GadgetReboot/PSM60_Fader_Controller/README.md

# PSM60_Fader_Controller
Motorized fader pot controller
