GadgetReboot/PSM60_Fader_Controller/Sketch/readme.md

FadePotTestATTiny804.ino is the sketch for the ATTiny804 controlling the fader pot motor<br>
fader_pot_controller_demo.ino is an I2C controller demo sketch for Uno to accept user input from the serial monitor and control the fader pot over I2C
