GadgetReboot/PSM60_Fader_Controller/GR_Slide_Pot_Controller_Sch.pdf

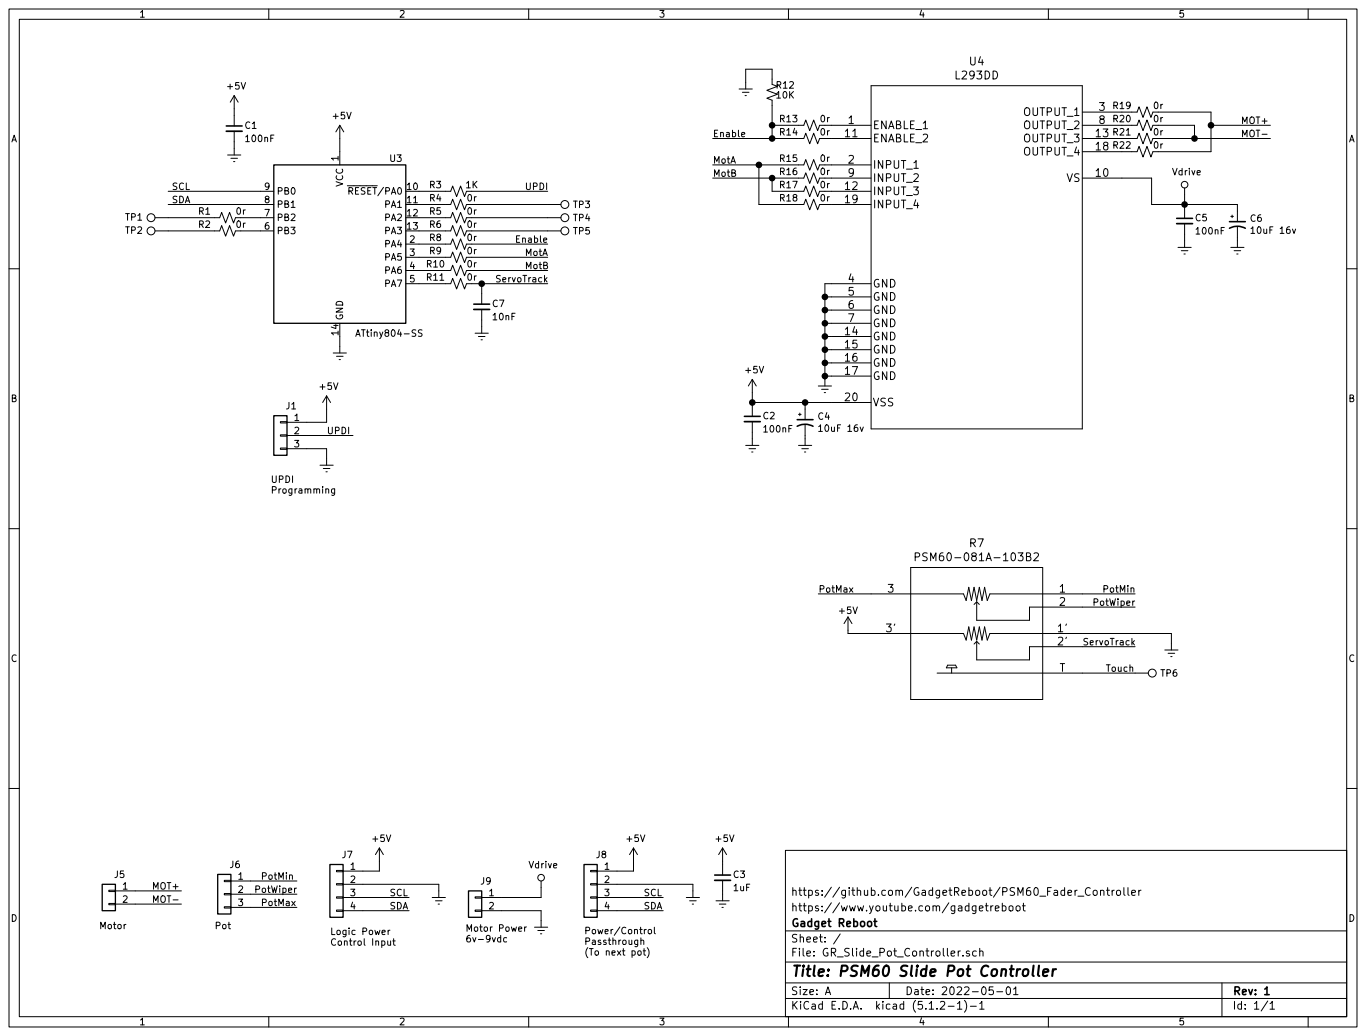
[picture p1: page 1]

https://github.com/GadgetReboot/PSM60_Fader_Controller C3

(To next pot) SDA

https://www.youtube.com/gadgetreboot
File: GR_Slide_Pot_Controller.sch Sheet: / Gadget Reboot

Id: 1/1 Title: PSM60 Slide Pot Controller
