GadgetReboot/PSM60_Fader_Controller/KiCad/GR_Slide_Pot_Controller.kicad_pcb

## KiCad design KiCad/GR_Slide_Pot_Controller.kicad_pcb (2023-11-27)

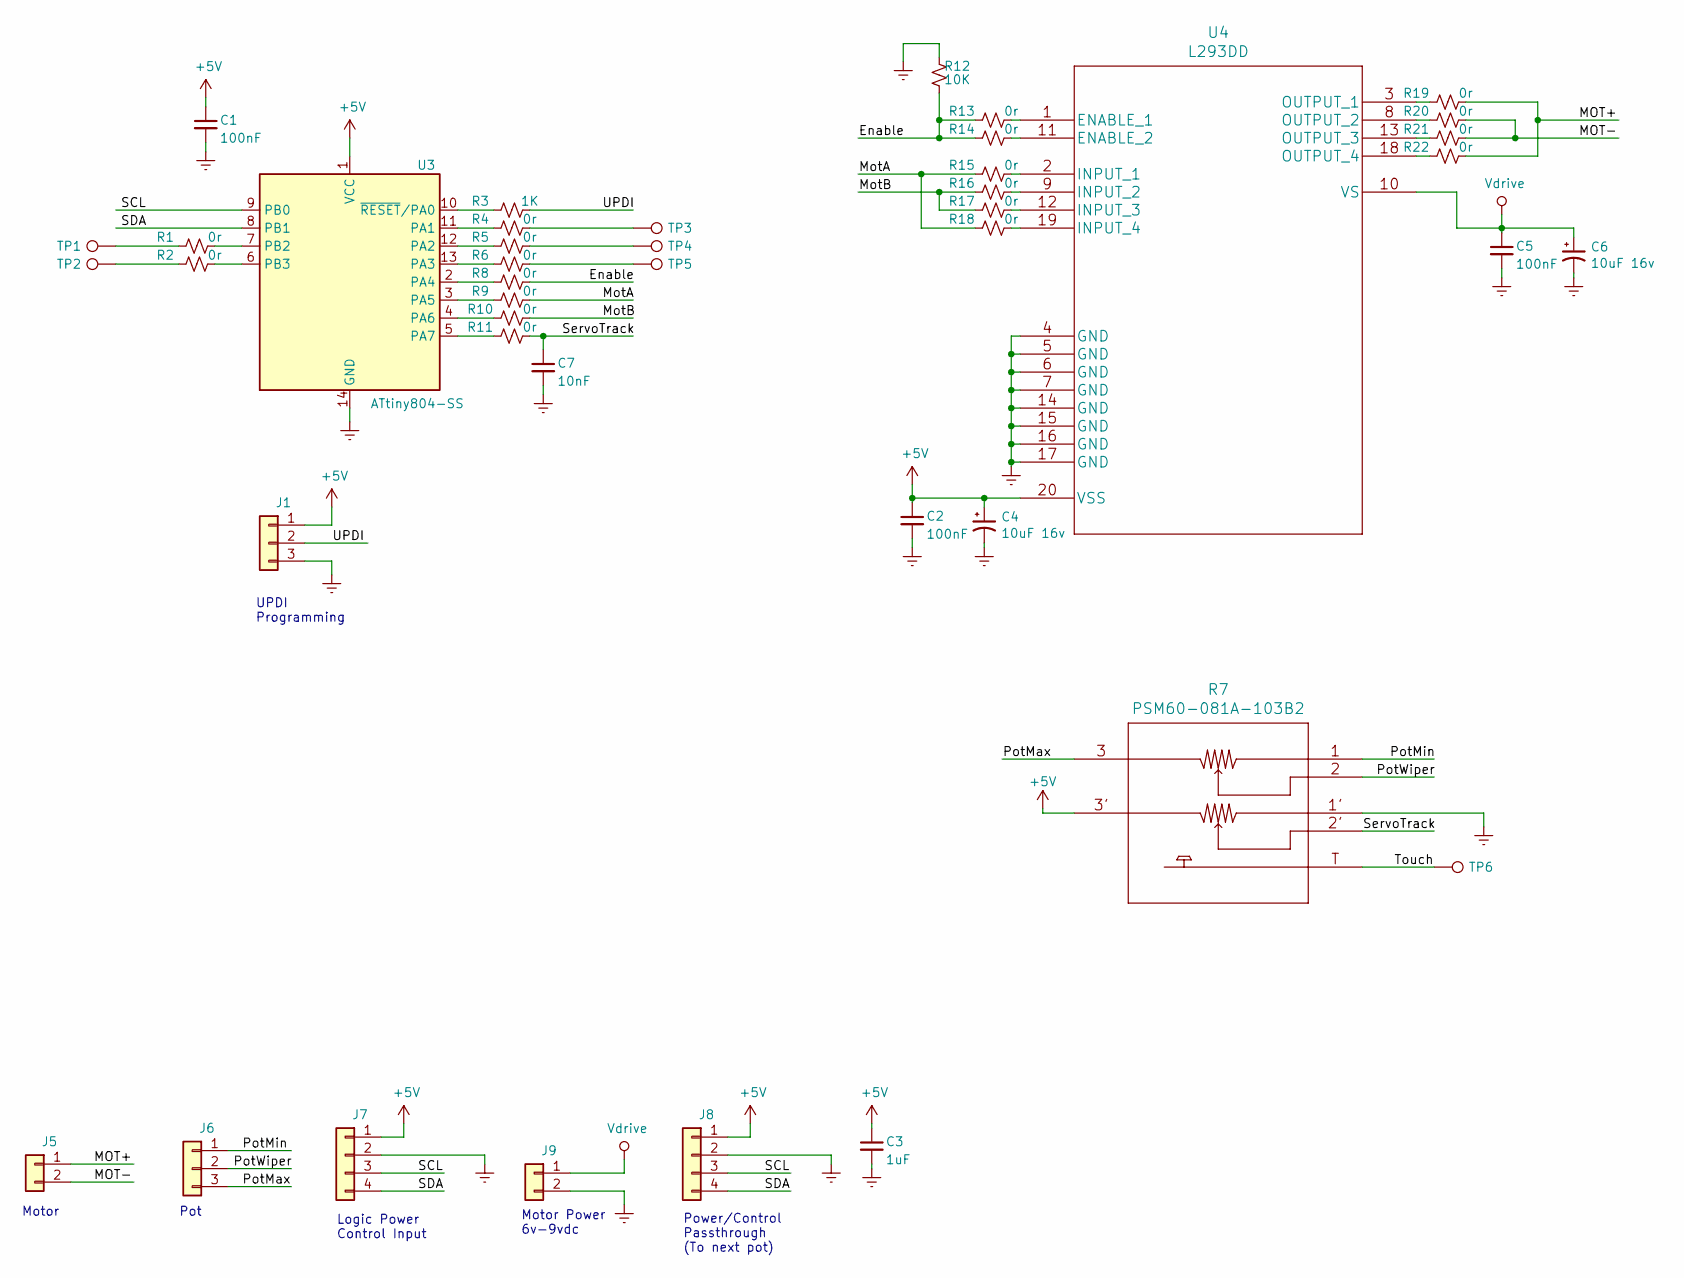
[picture p2: schematic GR_Slide_Pot_Controller.sch, PSM60 Slide Pot Controller]

Parts:
C1, C2, C5: 100nF; C_0805_2012Metric_Pad1.15x1.40mm_HandSolder
C3: 1uF; C_0805_2012Metric_Pad1.15x1.40mm_HandSolder
C4, C6: 10uF 16v; C_Elec_4x5.4
C7: 10nF; C_0805_2012Metric_Pad1.15x1.40mm_HandSolder
J1: Conn_01x03; PinHeader_1x03_P2.54mm_Vertical
J5, J9: Conn_01x02; JST_XH_S2B-XH-A-1_1x02_P2.50mm_Horizontal
J6: Conn_01x03; JST_XH_S3B-XH-A-1_1x03_P2.50mm_Horizontal
J7, J8: Conn_01x04; JST_XH_S4B-XH-A-1_1x04_P2.50mm_Horizontal
R1, R2, R4, R5, R6, R8, R9, R10, R11, R13, R14, R15, R16, R17, R18, R19, R20, R21, R22: 0r; R_0603_1608Metric_Pad1.05x0.95mm_HandSolder
R3: 1K; R_0805_2012Metric_Pad1.15x1.40mm_HandSolder
R7: PSM60-081A-103B2
R12: 10K; R_0805_2012Metric_Pad1.15x1.40mm_HandSolder
TP1, TP2, TP3, TP4, TP5, TP6: TestPoint; TestPoint_Pad_D1.0mm
U3: ATtiny804-SS; SOIC-14_3.9x8.7mm_P1.27mm
U4: L293DD

Connections:
+5V: C1.1, C2.1, C3.1, C4.1, J1.1, J7.1, J8.1, R7.3' (3_2), U3.1 (VCC), U4.20 (VSS)
/Enable: R8.1, R12.1, R13.2, R14.2
/MOT+: J5.1, R19.1, R22.1
/MOT-: J5.2, R20.1, R21.1
/MotA: R9.1, R15.2, R18.2
/MotB: R10.1, R16.2, R17.2
/PotMax: J6.3, R7.3
/PotMin: J6.1, R7.1
/PotWiper: J6.2, R7.2
/SCL: J7.3, J8.3, U3.9 (PB0)
/SDA: J7.4, J8.4, U3.8 (PB1)
/ServoTrack: C7.1, R7.2' (2_2), R11.1
/Touch: R7.T, TP6.1
/UPDI: J1.2, R3.1
GNDREF: C1.2, C2.2, C3.2, C4.2, C5.2, C6.2, C7.2, J1.3, J7.2, J8.2, J9.2, R7.1' (1_2), R12.2, U3.14 (GND), U4.4 (GND), U4.5 (GND), U4.6 (GND), U4.7 (GND), U4.14 (GND), U4.15 (GND), U4.16 (GND), U4.17 (GND)
unnamed: R1.1, U3.7 (PB2)
unnamed: R1.2, TP1.1
unnamed: R2.1, U3.6 (PB3)
unnamed: R2.2, TP2.1
unnamed: R3.2, U3.10 (~RESET~/PA0)
unnamed: R4.1, TP3.1
unnamed: R4.2, U3.11 (PA1)
unnamed: R5.1, TP4.1
unnamed: R5.2, U3.12 (PA2)
unnamed: R6.1, TP5.1
unnamed: R6.2, U3.13 (PA3)
unnamed: R8.2, U3.2 (PA4)
unnamed: R9.2, U3.3 (PA5)
unnamed: R10.2, U3.4 (PA6)
unnamed: R11.2, U3.5 (PA7)
unnamed: R13.1, U4.1 (ENABLE_1)
unnamed: R14.1, U4.11 (ENABLE_2)
unnamed: R15.1, U4.2 (INPUT_1)
unnamed: R16.1, U4.9 (INPUT_2)
unnamed: R17.1, U4.12 (INPUT_3)
unnamed: R18.1, U4.19 (INPUT_4)
unnamed: R19.2, U4.3 (OUTPUT_1)
unnamed: R20.2, U4.8 (OUTPUT_2)
unnamed: R21.2, U4.13 (OUTPUT_3)
unnamed: R22.2, U4.18 (OUTPUT_4)
Vdrive: C5.1, C6.1, J9.1, U4.10 (VS)

Notes on the sheet:
Motor
Pot
Logic Power Control Input
Power/Control Passthrough (To next pot)
Motor Power 6v-9vdc
UPDI Programming

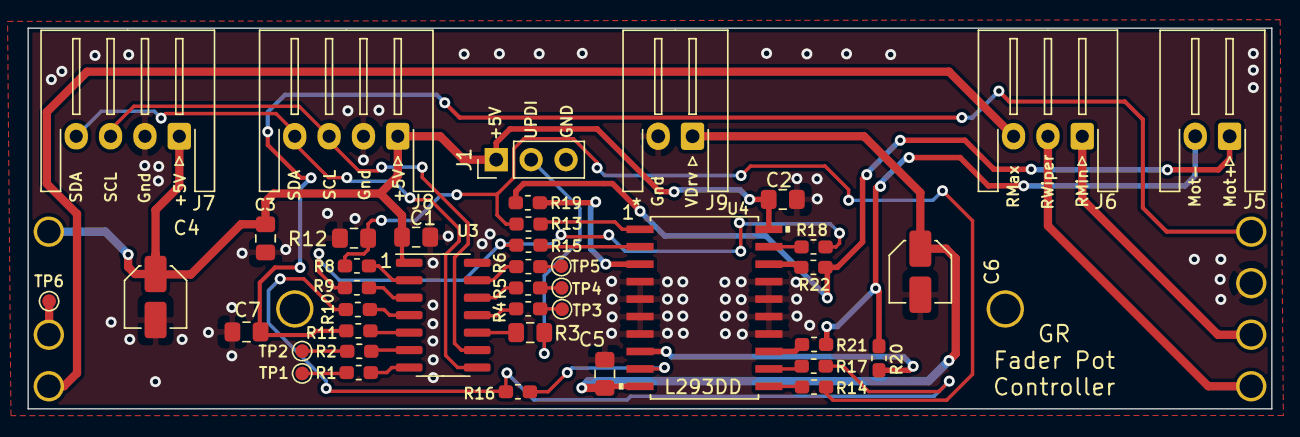
[picture p3: board GR_Slide_Pot_Controller.kicad_pcb from above]

Board: 2 copper layers, 90.5 x 27.7 mm, 43 parts (1 on the bottom side), 41 nets.
